antevir/sabiana_cvb_mod/hw/controller_board/controller_board.kicad_pcb

## KiCad design hw/controller_board/controller_board.kicad_pcb (2025-05-24)

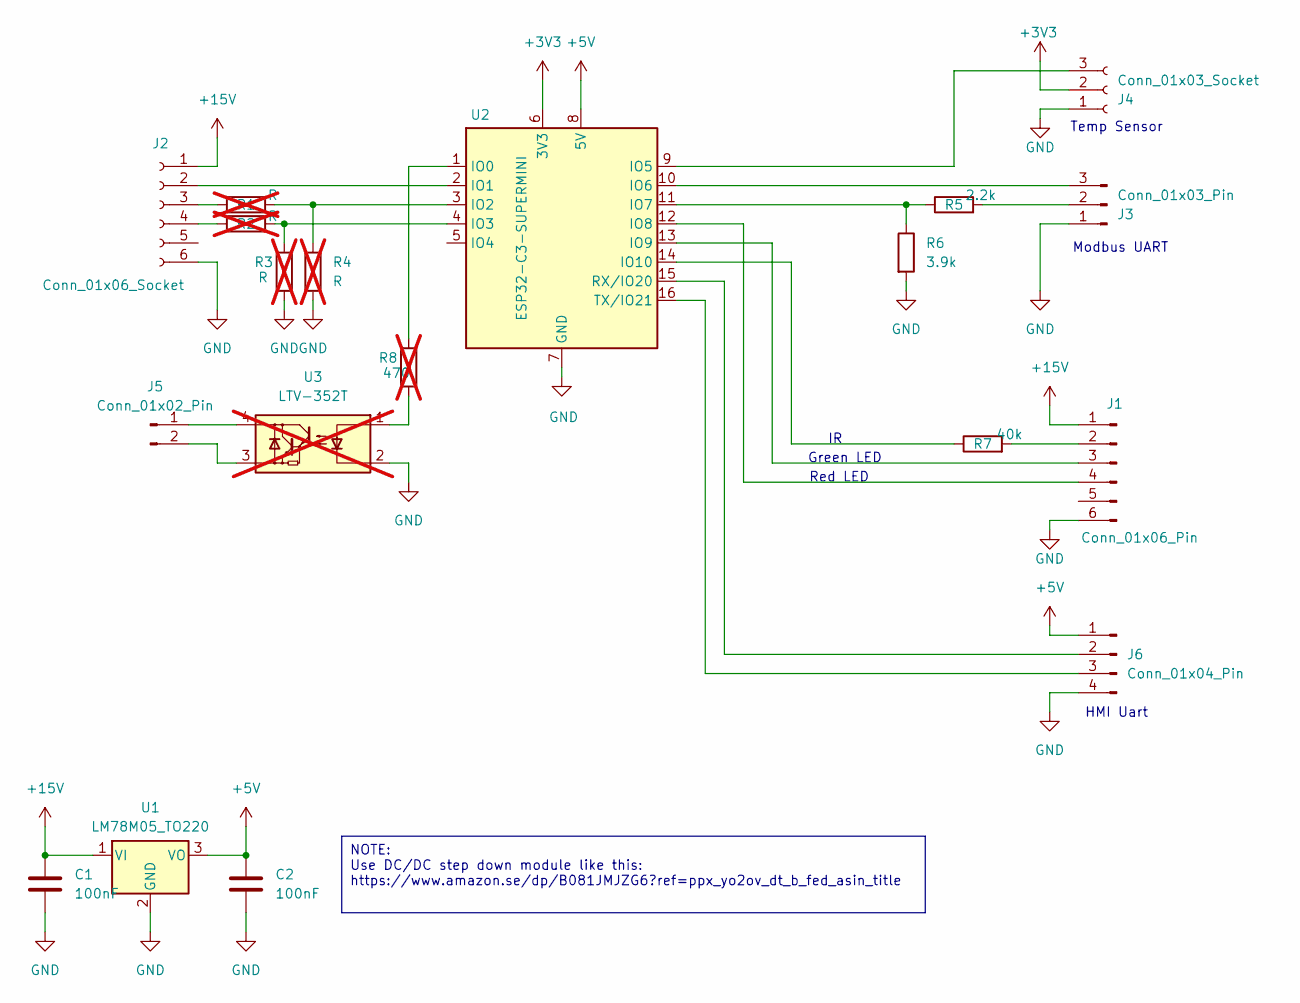
[picture p4: schematic controller_board.kicad_sch]

Parts:
C1, C2: 100nF; C_0603_1608Metric_Pad1.08x0.95mm_HandSolder
J1: Conn_01x06_Pin; PinHeader_1x06_P2.54mm_Vertical
J2: Conn_01x06_Socket; PinSocket_1x06_P2.54mm_Horizontal
J3: Conn_01x03_Pin; PinHeader_1x03_P2.54mm_Vertical
J4: Conn_01x03_Socket; PinSocket_1x03_P2.54mm_Vertical
J5: Conn_01x02_Pin; PinHeader_1x02_P2.54mm_Vertical
J6: Conn_01x04_Pin; PinHeader_1x04_P2.54mm_Vertical
R1, R2, R3, R4: R; R_0603_1608Metric_Pad0.98x0.95mm_HandSolder; not fitted
R5: 2.2k; R_0603_1608Metric_Pad0.98x0.95mm_HandSolder
R6: 3.9k; R_0603_1608Metric_Pad0.98x0.95mm_HandSolder
R7: 40k; R_0603_1608Metric_Pad0.98x0.95mm_HandSolder
R8: 470; R_0603_1608Metric_Pad0.98x0.95mm_HandSolder; not fitted
U1: LM78M05_TO220; TO-220-3_Vertical
U2: ESP32-C3-SUPERMINI; esp32_c3_supermini2
U3: LTV-352T; SO-4_4.4x3.6mm_P2.54mm; not fitted

Connections:
+3V3: J4.2, U2.6 (3V3)
+5V: C2.1, J6.1, U1.3 (VO), U2.8 (5V)
+15V: C1.1, J1.1, J2.1, U1.1 (VI)
GND: C1.2, C2.2, J1.6, J2.6, J3.1, J4.1, J6.4, R3.2, R4.2, R6.2, U1.2 (GND), U2.7 (GND), U3.2
unnamed: J1.2, R7.2
unnamed: J1.3, U2.13 (IO9)
unnamed: J1.4, U2.12 (IO8)
unnamed: J2.2, U2.2 (IO1)
unnamed: J2.3, R1.1
unnamed: J2.4, R2.1
unnamed: J3.2, R5.2
unnamed: J3.3, U2.10 (IO6)
unnamed: J4.3, U2.9 (IO5)
unnamed: J5.1, U3.4
unnamed: J5.2, U3.3
unnamed: J6.2, U2.15 (RX/IO20)
unnamed: J6.3, U2.16 (TX/IO21)
unnamed: R8.2, U3.1
unnamed: R8.1, U2.1 (IO0)
unnamed: R1.2, R4.1, U2.3 (IO2)
unnamed: R2.2, R3.1, U2.4 (IO3)
unnamed: R5.1, R6.1, U2.11 (IO7)
unnamed: R7.1, U2.14 (IO10)

Notes on the sheet:
NOTE: Use DC/DC step down module like this: https://www.amazon.se/dp/B081JMJZG6?ref=ppx_yo2ov_dt_b_fed_asin_title
HMI Uart
Temp Sensor
Red LED
Modbus UART
Green LED

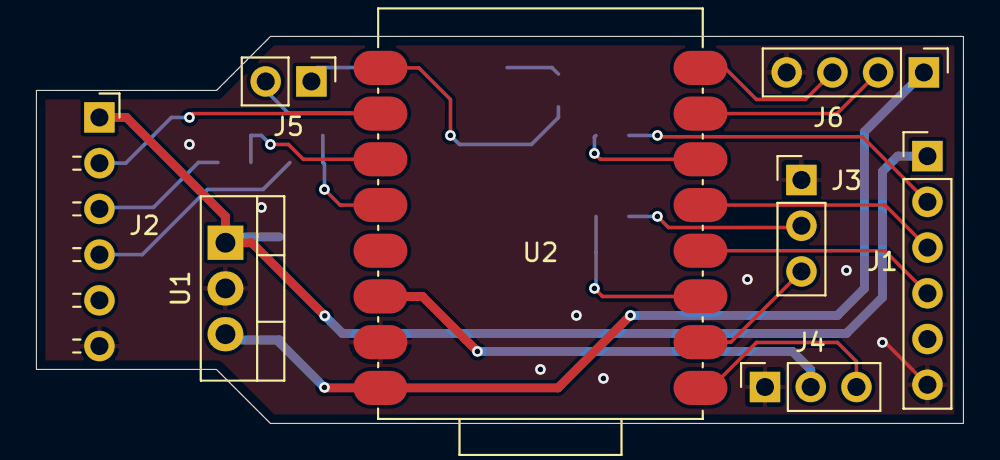
[picture p5: board controller_board.kicad_pcb from above]

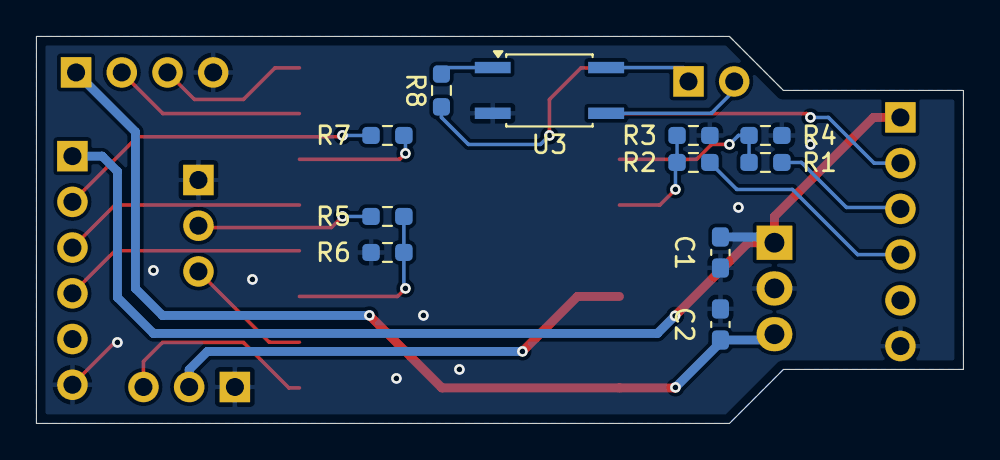
[picture p6: board controller_board.kicad_pcb from below]

Board: 2 copper layers, 51.5 x 21.5 mm, 19 parts (11 on the bottom side), 23 nets.
