antevir/sabiana_cvb_mod/sw/hmi/src/time_program_screen.cpp

#include "time_program_screen.hpp"

const char * const TimeProgramUI::PROFILE_NAMES[2] = { "Active", "Inactive" };
const char * const TimeProgramUI::DAY_NAMES[WEEK_DAYS] = { "Mon", "Tue", "Wed", "Thu", "Fri", "Sat", "Sun" };
