antevir/sabiana_cvb_mod/(commit log)

2025-05-24 Add controller board schematics & PCB
    [controller_board.kicad_pcb, controller_board.kicad_sch]
2025-11-03 Switch to SHT3x temp sensor
2025-11-03 Use custom partition table to free up mem
    [custom_partitions.csv]
2025-11-03 Power optimizations
    Try to lower the power so that we don't affect the temp sensor too much
    [main.cpp]
2025-11-03 Add heat dissipation comp for air temp
2025-11-22 Fix IR Off command
    [ir.cpp]
2025-11-22 controller: Minor power optimizations
2025-11-22 controller: Fix heating
2026-08-16 Fix overlapping Air/HW temps on the HMI and add a software README.
    [main_screen.hpp]
2026-08-16 Add a fan cycle during active hours to reduce mould.
2026-09-02 Move fan cycling into the controller
2026-11-07 Ignore empty infrared frames that decode as Off with setpoint 0.
2026-11-08 Document the panel, schedule, and fan cycle, and show the main screen.
